scottholdren/ledframe/pi/README.md

# The Pi as firmware

The voice box is a Raspberry Pi (4 B or 5 — either works), but it's treated like a microcontroller:
nothing on it is configured by hand, and starting over is a five-minute
mechanical procedure. Everything the box *is* lives in this directory.

| File | Role |
|---|---|
| `bootstrap.sh` | Run once on a fresh card (idempotent). Installs packages, venv, service, udev rule, secrets file. |
| `deploy.sh` | The "flash" button. rsyncs the working tree to the Pi and restarts the service. |
| `ledframe.service` | systemd unit: runs `python -m voice` as your user, restarts on crash. |
| `99-ledframe.rules` | udev rule so the ESP32-S3 is always `/dev/ledframe-wall`, whichever port it enumerates on. |
| `requirements.txt` | Python deps for the venv at `/opt/ledframe/venv`. |

Secrets (`ANTHROPIC_API_KEY`, `DEEPGRAM_API_KEY`) live only in
`/etc/ledframe.env` on the Pi, created empty by bootstrap.

## Flash a card (Mac)

1. Open **Raspberry Pi Imager** (`brew install --cask raspberry-pi-imager`).
2. Device: Raspberry Pi 4 (or 5). OS: **Raspberry Pi OS Lite (64-bit)**. Storage: the card.
3. Click **Edit Settings** before writing, and set:
   - Hostname `ledframe`
   - Username `scott`, a password
   - Wi-Fi SSID/password, country `US`
   - Services tab: **Enable SSH → Allow public-key authentication only**, paste
     the contents of `~/.ssh/id_ed25519_oss.pub`
   Imager remembers these, so the second card is just "Write".
4. Write. Move the card to the Pi, power it, wait ~90 s.

## First boot

The first `sudo` on a fresh card asks for your password (Debian 13 / Trixie
dropped passwordless sudo for the first user). Bootstrap installs a
NOPASSWD rule so it's the only time. Bootstrap also sets the Wi-Fi country
and unblocks the radio — on Trixie, Wi-Fi stays soft-blocked until a
regulatory domain is set, even with a saved network. If the Pi doesn't
show up on Wi-Fi at first boot, plug in Ethernet for the bootstrap.

```sh
ssh scott@ledframe.local
curl -fsSL https://raw.githubusercontent.com/scottholdren/ledframe/main/pi/bootstrap.sh | sudo bash
sudo nano /etc/ledframe.env        # paste the two API keys
sudo systemctl restart ledframe
journalctl -fu ledframe            # should list audio devices and heartbeat
```

## Day to day

```sh
pi/deploy.sh                       # push code + restart
ssh scott@ledframe.local journalctl -fu ledframe
```

## Make it bulletproof (once it's in the frame)

`sudo raspi-config` → Performance Options → Overlay File System → enable.
The root filesystem becomes read-only in RAM; pulling the plug can't corrupt
the card. To update code, disable the overlay, reboot, deploy, re-enable.
Keep a second card flashed and bootstrapped in the frame's back pocket.

## Recovery

Swap in the spare card. Or: Imager → Write (settings remembered) → first
boot steps above. There is nothing else to restore; the animation library
is the one thing worth backing up (`/opt/ledframe/library/`, once it exists).

## Power

Give the Pi its own official supply on its own cord, not a tap off the LED
rail — keeps PSU noise out of the audio path.

- **Pi 4 B**: official 15 W (5.1 V 3 A). USB ports get ~1.2 A total, enough
  for the ReSpeaker + small speaker. Passive heatsink is sufficient.
- **Pi 5**: official 27 W. Without a PD supply the Pi 5 caps USB at 600 mA;
  bootstrap sets `usb_max_current_enable=1` on Pi 5 only, as a fallback.

## Bench mic: INMP441 on the GPIO header

Until the ReSpeaker arrives, a single INMP441 I2S mic works for desk tests.
Enabled by two lines in `/boot/firmware/config.txt` (already on the box):

```
dtparam=i2s=on
dtoverlay=googlevoicehat-soundcard
```

It shows up as `card 1: sndrpigooglevoi`. Wiring (Pi 4 header, physical pins):

| INMP441 | Pi pin | Signal |
|---|---|---|
| VDD | 1 | 3.3 V (not 5 V) |
| GND | 6 | GND |
| SCK | 12 | GPIO 18, I2S bit clock |
| WS  | 35 | GPIO 19, I2S word select |
| SD  | 38 | GPIO 20, I2S data in |
| L/R | 6 (GND) | left channel |

Test: `arecord -D hw:1,0 -f S32_LE -r 48000 -c 2 -d 5 test.wav && aplay -D hw:0,0 test.wav`
(the mic is on the left channel; the right is silence). Remove the two config
lines when the ReSpeaker takes over — it's plain USB audio.
