scottholdren/ledframe/hardware/baffle-2x2.png

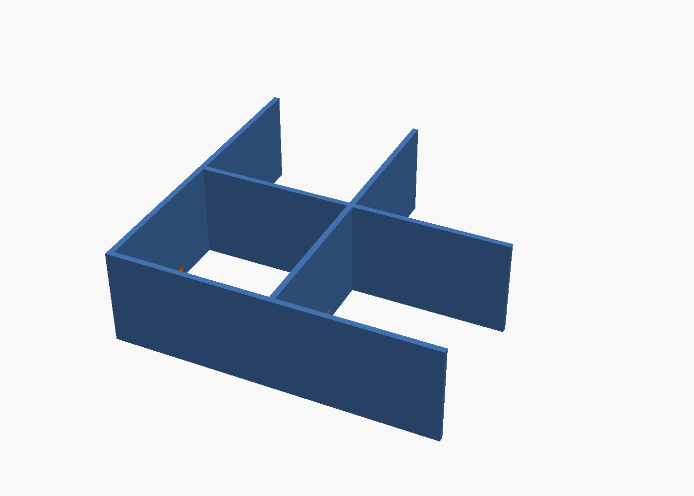
hardware/baffle-2x2.png
