scottholdren/ledframe/hardware/baffle-2x2-L.stl

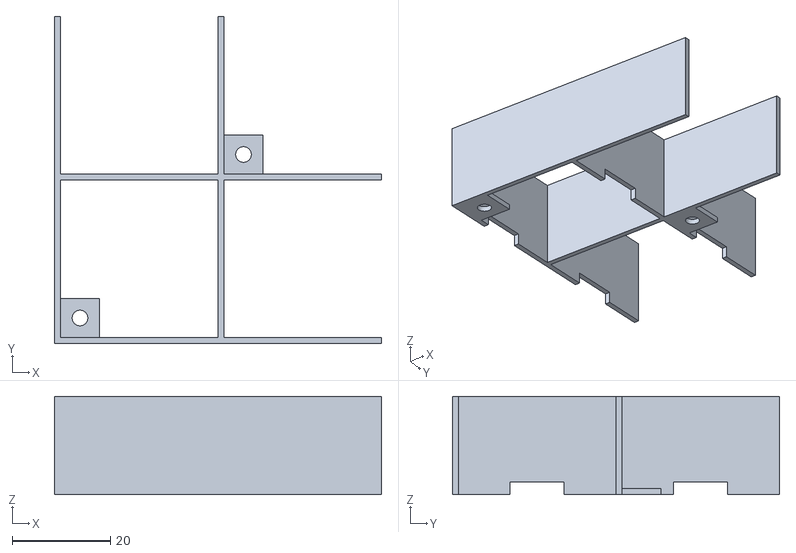
[picture p2: CAD file, 2026-09-06]
hardware/baffle-2x2-L.stl
66.7 x 66.7 x 20.0
