scottholdren/ledframe/hardware/baffle-2x2-closed.stl

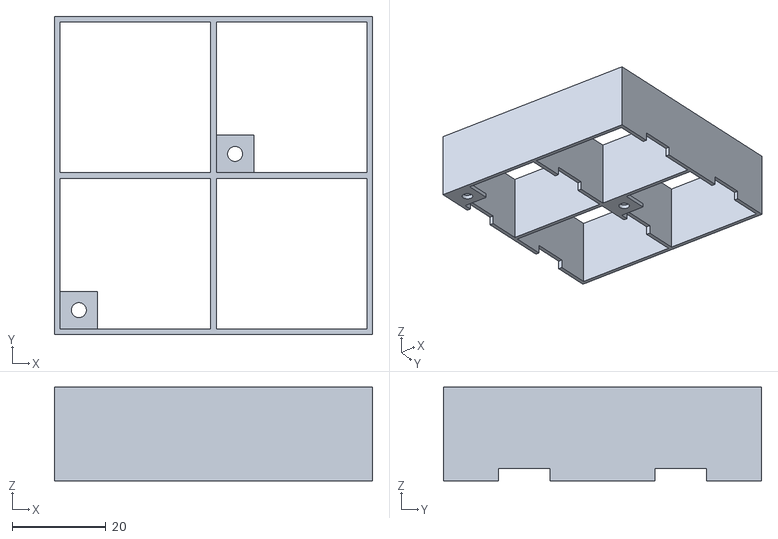
[picture p3: CAD file, 2026-09-06]
hardware/baffle-2x2-closed.stl
67.9 x 67.9 x 20.0
