scottholdren/ledframe/(commit log)

2026-09-04 Add optical test-rig sample shopping list
    Claude-Session: https://claude.ai/code/session_01L6qPW7A5GwYrUZTefRtE1A
2026-09-04 Note LED strip part number and reel math
    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
2026-09-04 Decide delivery channel: USB serial Pi -> ESP32, GitHub as fallback
    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
2026-09-04 Support Pi 4 B: guard Pi 5 USB-current tweak, update power notes
    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
2026-09-05 Document INMP441 bench mic wiring and I2S overlay
    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
2026-09-05 Earcons: synthesized heard/working/done/unheard/error cues, aplay playback
    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
    [earcons.py]
2026-09-05 Earcons: adopt shimmer as 'working' and glass note as 'done'; heard is the inverted bloom
    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
    [earcons.py]
2026-09-06 Baffle grid: parametric OpenSCAD tile, 2x2 test print STL
    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
    [baffle-2x2.stl, baffle.scad]
2026-09-06 Baffle: production tile STLs (6x6 and 6x3) for the Ender 5
    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
    [baffle-6x3.stl, baffle-6x6.stl]
2026-09-06 Baffle: L-tiles with full-thickness walls, open far edges; closed 2x2 test variant
    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
    [baffle-2x2-L.stl, baffle-2x2-closed.stl, baffle-2x2.stl, baffle-6x3.stl, baffle-6x6.stl, baffle.scad]
